MassimoPiva/EIS/BOARD/20170425_183256104_iOS.jpg

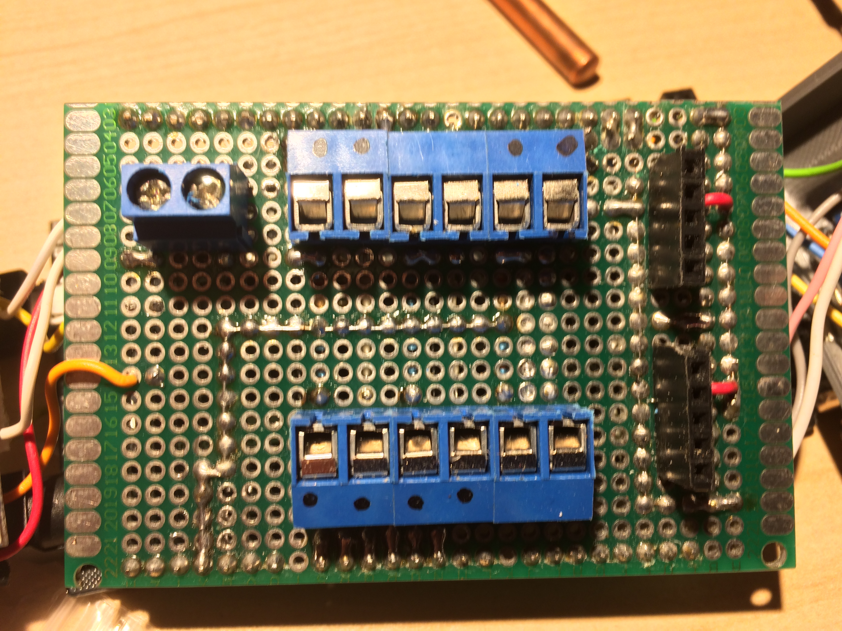
BOARD/20170425_183256104_iOS.jpg
