MassimoPiva/EIS/BOARD/20170425_183319681_iOS.jpg

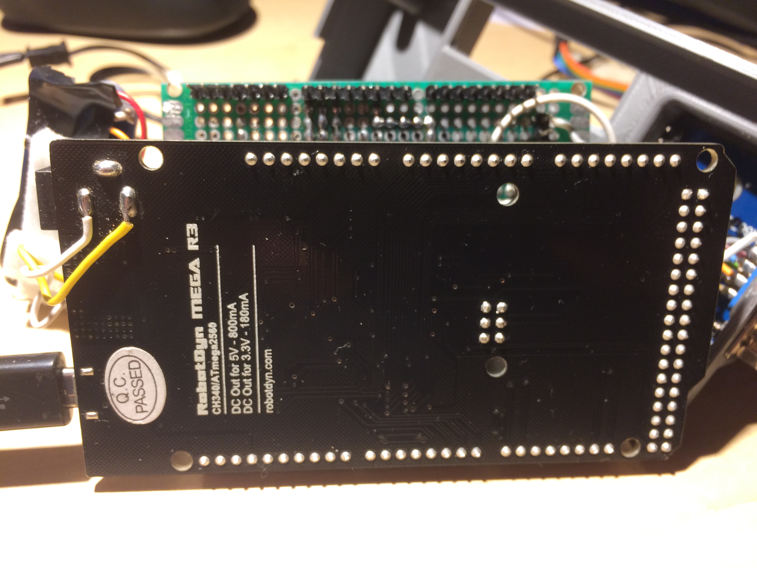
BOARD/20170425_183319681_iOS.jpg
