MassimoPiva/EIS/EIS/Release Note.txt

VERSIONE 1.0
2017-05-07
INSTALLATA SU STRUMENTO ON-BOARD 2017-05-07
