MassimoPiva/EIS/BOARD/20170425_182959737_iOS.jpg

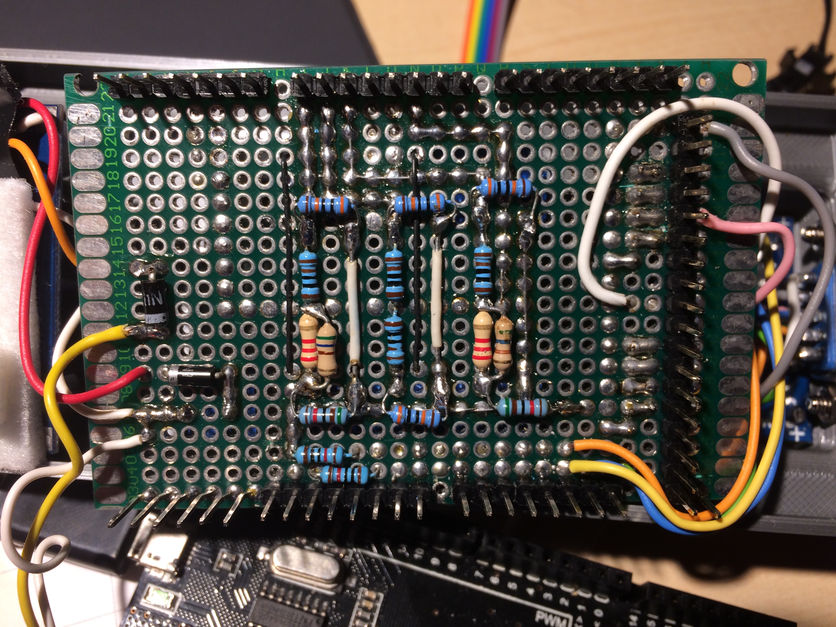
BOARD/20170425_182959737_iOS.jpg
