MassimoPiva/EIS/BOARD/20170425_183319781_iOS.jpg

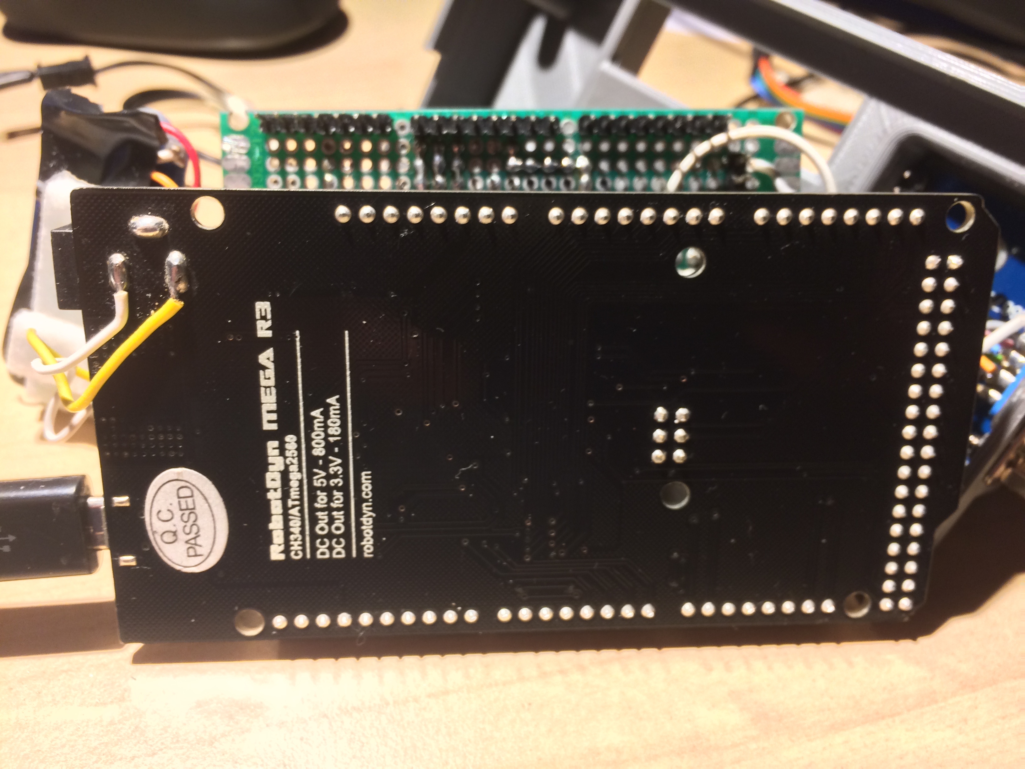
BOARD/20170425_183319781_iOS.jpg
